SL2000s/birdfeeder_pub/webserver/images/blog.jpg

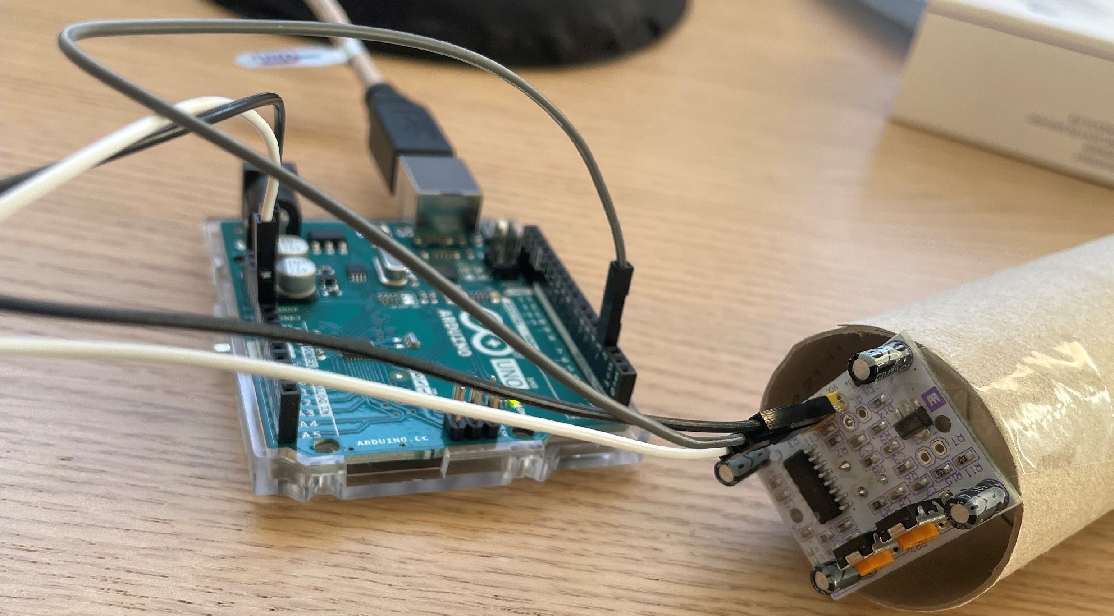
webserver/images/blog.jpg
