SL2000s/birdfeeder_pub/webserver/assets/jpgraph/Examples/classroom.jpg

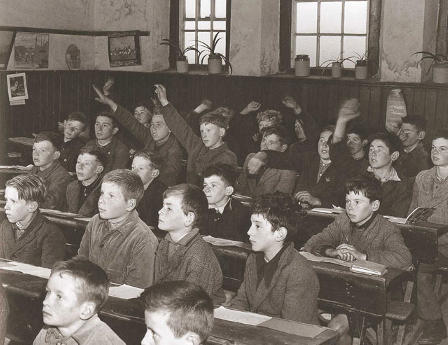
webserver/assets/jpgraph/Examples/classroom.jpg
