SL2000s/birdfeeder_pub/video/link.txt

https://www.youtube.com/watch?v=Qcx8fapgNeI&ab_channel=Oskise
