SL2000s/birdfeeder_pub/birdfeeder_chassi/SMALL_MKIII_image.png

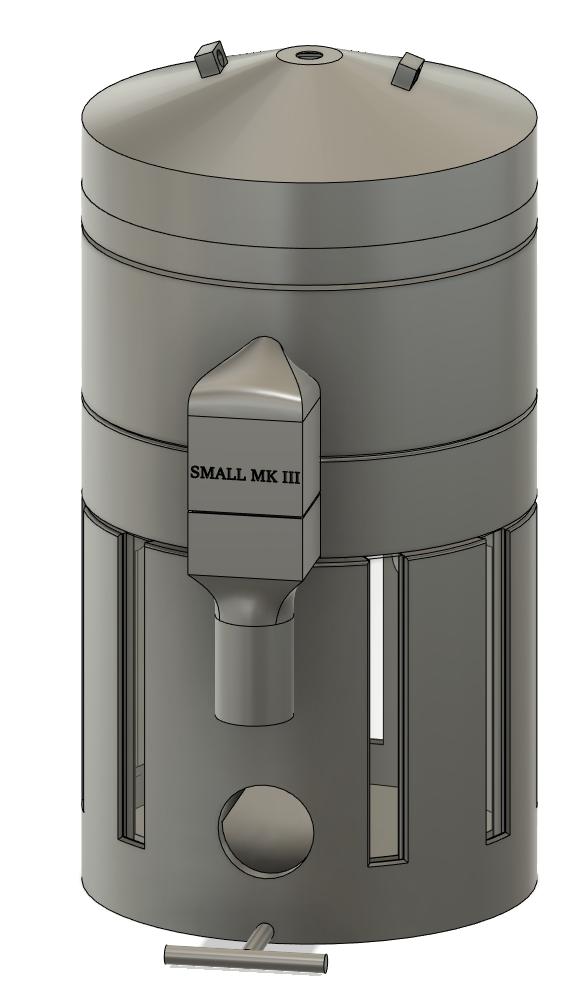
birdfeeder_chassi/SMALL_MKIII_image.png
