SL2000s/birdfeeder_pub/webserver/assets/jpgraph/Examples/blueblack400x300grad.png

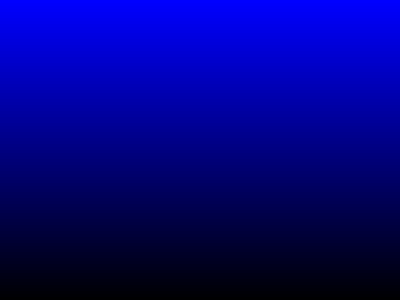
webserver/assets/jpgraph/Examples/blueblack400x300grad.png
