SL2000s/birdfeeder_pub/webserver/assets/jpgraph/Examples/dm_ex6.png

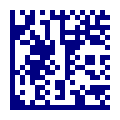
webserver/assets/jpgraph/Examples/dm_ex6.png
