SL2000s/birdfeeder_pub/webserver/assets/jpgraph/Examples/fireplace.jpg

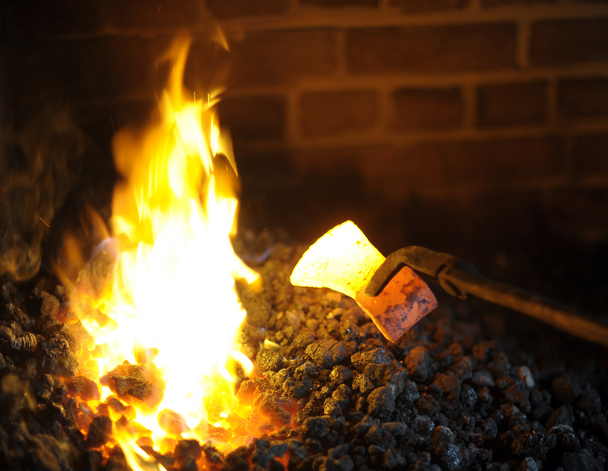
webserver/assets/jpgraph/Examples/fireplace.jpg
