SL2000s/birdfeeder_pub/webserver/assets/jpgraph/Examples/heat1.jpg

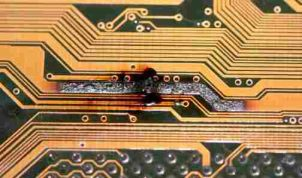
webserver/assets/jpgraph/Examples/heat1.jpg
