SL2000s/birdfeeder_pub/webserver/assets/jpgraph/Examples/ironrod.jpg

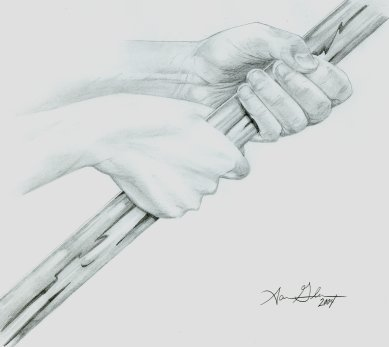
webserver/assets/jpgraph/Examples/ironrod.jpg
