SL2000s/birdfeeder_pub/webserver/assets/jpgraph/Examples/qrexample03.png

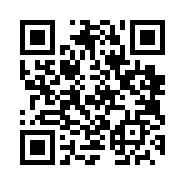
webserver/assets/jpgraph/Examples/qrexample03.png
