SL2000s/birdfeeder_pub/webserver/assets/jpgraph/Examples/stship.jpg

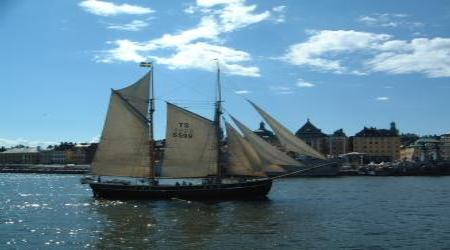
webserver/assets/jpgraph/Examples/stship.jpg
