SL2000s/birdfeeder_pub/webserver/assets/jpgraph/Examples/tiger1.jpg

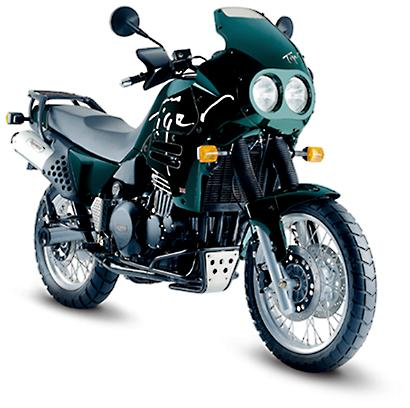
webserver/assets/jpgraph/Examples/tiger1.jpg
