SL2000s/birdfeeder_pub/webserver/assets/jpgraph/Examples/tiger_bkg.gif

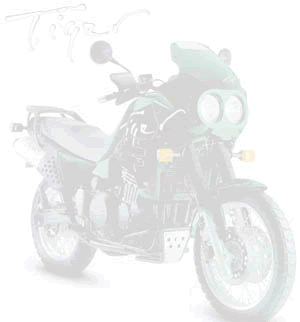
webserver/assets/jpgraph/Examples/tiger_bkg.gif
