SL2000s/birdfeeder_pub/webserver/assets/jpgraph/Examples/tiger_bkg.jpg

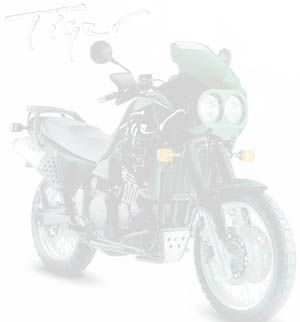
webserver/assets/jpgraph/Examples/tiger_bkg.jpg
