SL2000s/birdfeeder_pub/webserver/assets/jpgraph/Examples/worldmap1.jpg

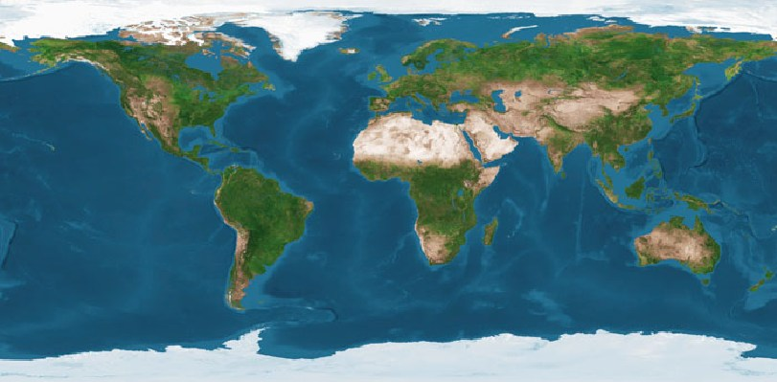
webserver/assets/jpgraph/Examples/worldmap1.jpg
