SL2000s/birdfeeder_pub/webserver/images/bird1.jpg

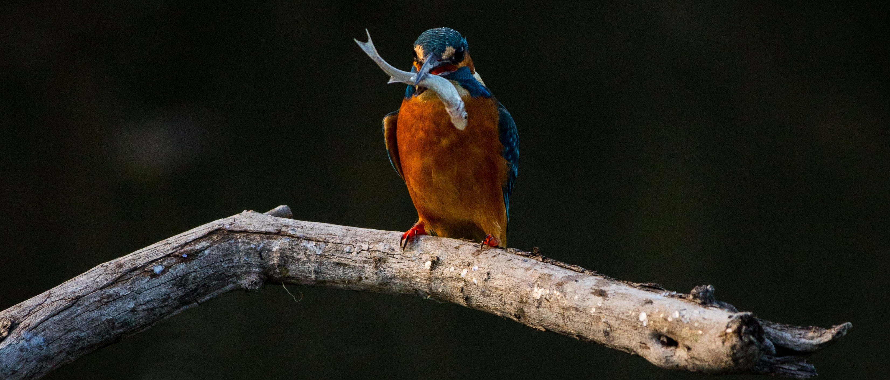
webserver/images/bird1.jpg
