SL2000s/birdfeeder_pub/webserver/images/bird1_orig.jpg

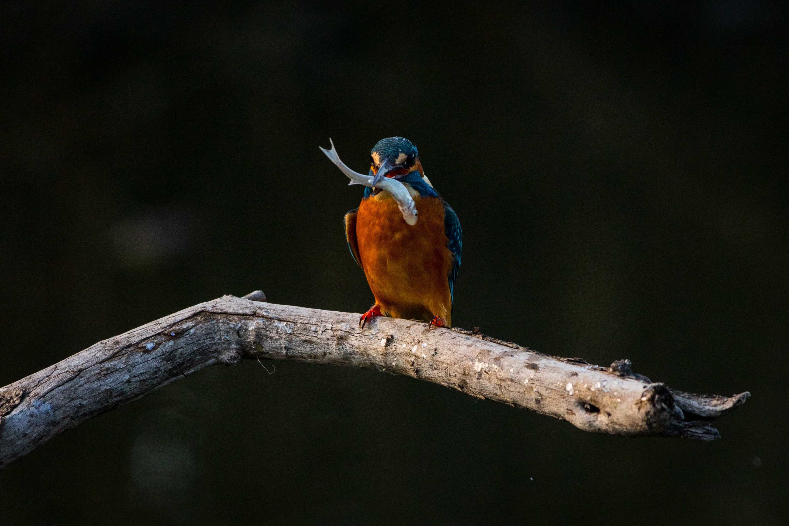
webserver/images/bird1_orig.jpg
