SL2000s/birdfeeder_pub/webserver/images/bird2.jpg

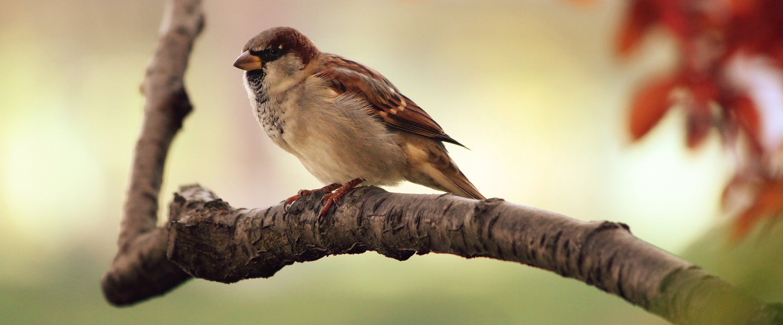
webserver/images/bird2.jpg
