SL2000s/birdfeeder_pub/webserver/images/bird3.jpg

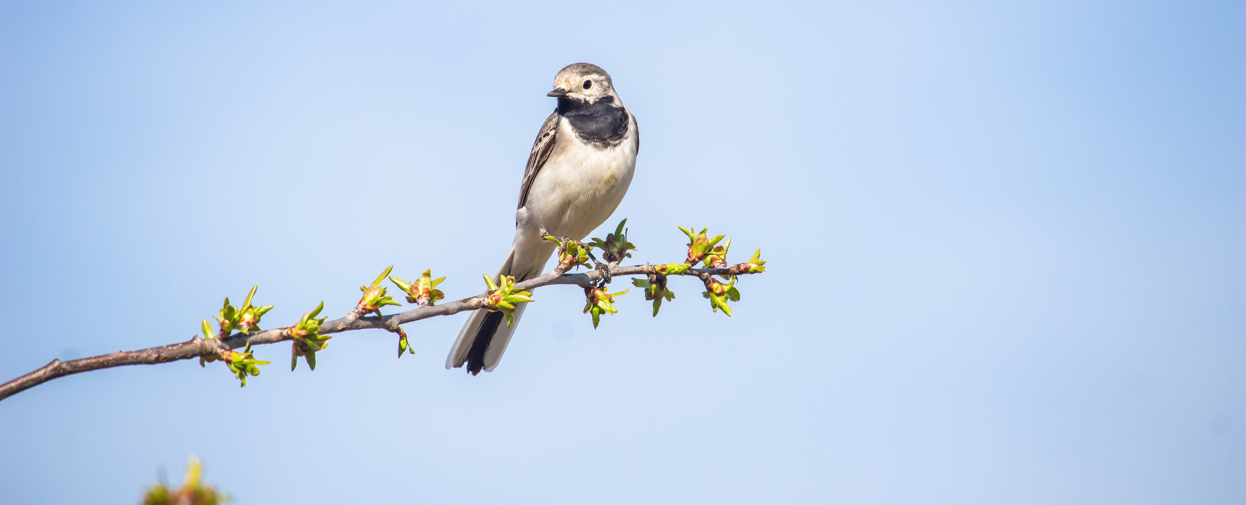
webserver/images/bird3.jpg
