SL2000s/birdfeeder_pub/webserver/images/bird-9950.jpg

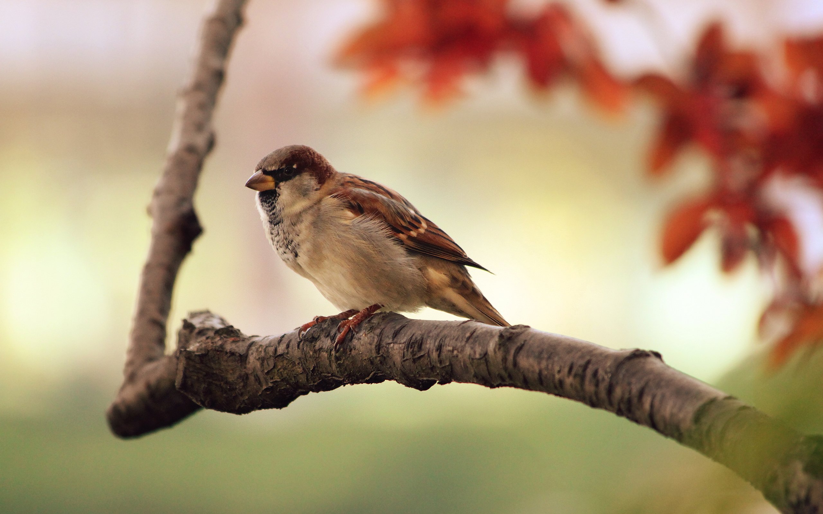
webserver/images/bird-9950.jpg
