SL2000s/birdfeeder_pub/webserver/images/sun.png

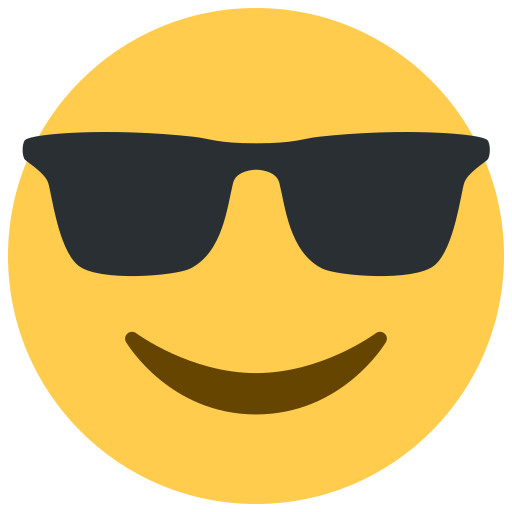
webserver/images/sun.png
