SL2000s/birdfeeder_pub/birdfeeder_chassi/SMALL_MKIII_step_file.step

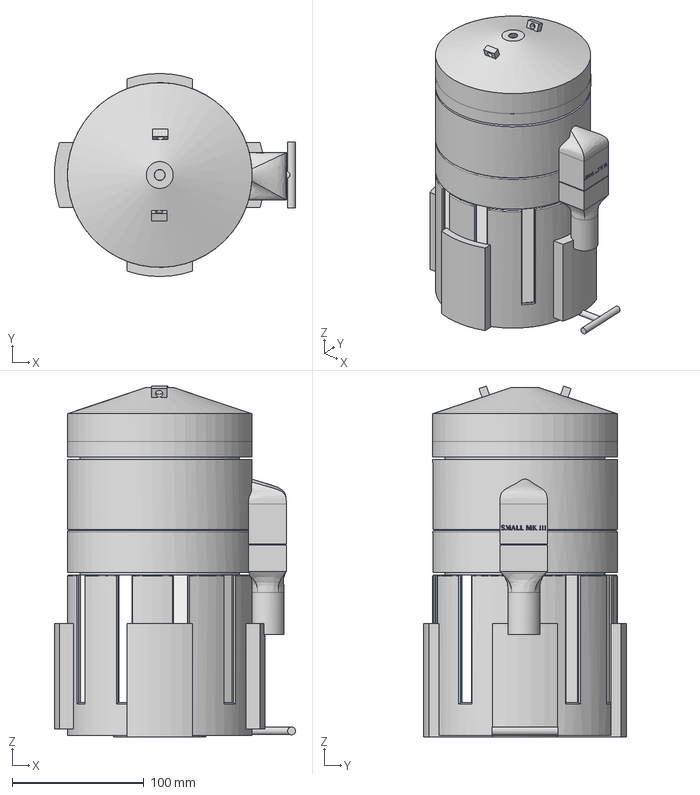
[picture p31: CAD file, 2022-05-09]
birdfeeder_chassi/SMALL_MKIII_step_file.step
182.8 x 154.0 x 266.2 mm
