SL2000s/birdfeeder_pub/(commit log)

2022-05-09 Add all locale files
    [Kilo Romeo 92 Alpha v31.step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]
2022-05-09 Rename files to more descriptive names
    [SMALL_MKIII_step_file.step]
2022-05-13 Rename files according to name convention
    [antenna_on_feeder_optimum.gbr, just_antenna_optimum.gbr]
